fourstix/MCard1802TeensyPixieVideo/docs/TeensyPixieVideo.pdf

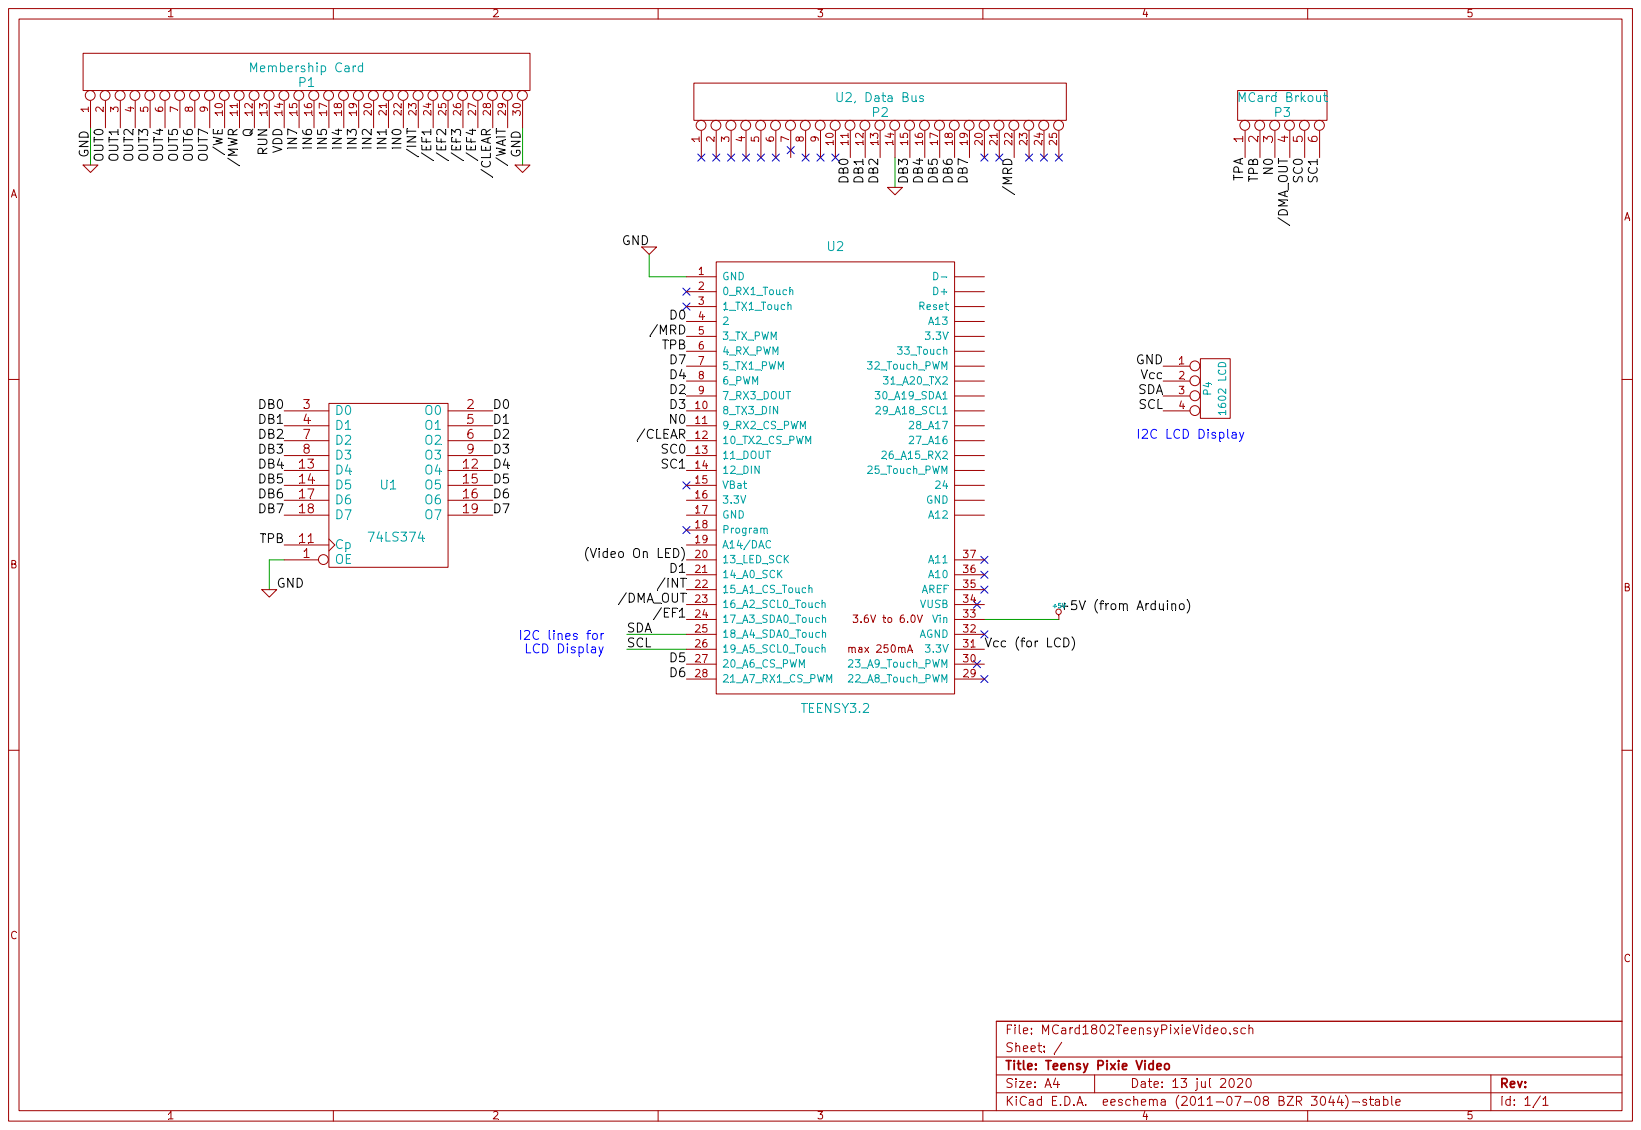
[picture p9: page 1]
