fourstix/MCard1802TeensyPixieVideo/(threads)

Thread 2 (2020-07-01):

Add Example pictures

fourstix, 2020-07-01:
Add pictures of Example programs.  Cosmac Spaceship, Seconds Clock, Video DMA Test, 96 char test demo, and Sprite.

fourstix, 2020-07-02:
Added example pictures.  Saves as png to fix image rotation issues.

Closed 2020-07-02.

Thread 4 (2020-09-08):

Add Support for SPI OLED

fourstix, 2020-09-08:
There are enough digital pins available on the Teensy 3.2 to support SPI OLED displays.

Some of the pins need to be re-arranged to free up pins 10, 11, 12 and 13 for SPI.  The CS output can be on any pin, but the conventional location for CS is pin 10.

Video_On would need to be moved from the LED pin 13, which is used for SCK in SPI.   Even if it isn't on the built in LED pin anymore, Video_On is part of the external design, and should be moved to another pin.

fourstix, 2020-09-08:
Since SDA and SCL are not required for SPI, pins 19 and 18 are available.   We can move SCO and SC1 to these pins to free up pins 11 and 13.

Pin 10 is /Clear and can be moved to the unused pin 22, and pin 13 Video_On can be moved to the unused pin 23.

The new pin assignments can be:
Pin 10     CS        (SPI)
Pin 11     DOUT   (SPI)
Pin 12     DIN      (SPI)
Pin 13     SCK      (SPI)

Pin 18     SCO      (was Pin 11)
Pin 19     SC1       (was Pin 12)

Pin 22      /Clear   (was Pin 10)
Pin 23      Video_On (was Pin 13)

fourstix, 2020-09-09:
Hmmm... Some SPI displays have an RST (Reset)  and DC (Data/Command) inputs as well.    So there needs to be 5 pins, not 4.  Video_On may have to go.  DIN isn't used for displays, so maybe we can move /Clear to that pin.

Otherwise, we are out of pins and would have to use some of the digital IO pins available as pads on the bottom or use a Teensy 3.5 which is longer and has the additional data pins brought out.

fourstix, 2021-01-27:
A Pixie Video simulator using SPI and a 4 wire GLCD was made for the Pico/Elf v2 microcomputer. It is available in the [fourstix/PicoElfPixieVideoGLCD]([url]https://github.com/fourstix/PicoElfPixieVideoGLCD(url)) repository.
