fourstix/MCard1802TeensyPixieVideo/(commit log)

2020-07-01 update readme with schematic
2020-07-13 Updated schematic with display
2020-07-13 Updated schematic picture
